Tech500/EoRa-S3-900TB-with-FreeRTOS/Doc/EoRa-S3-900TB Dev Board.png

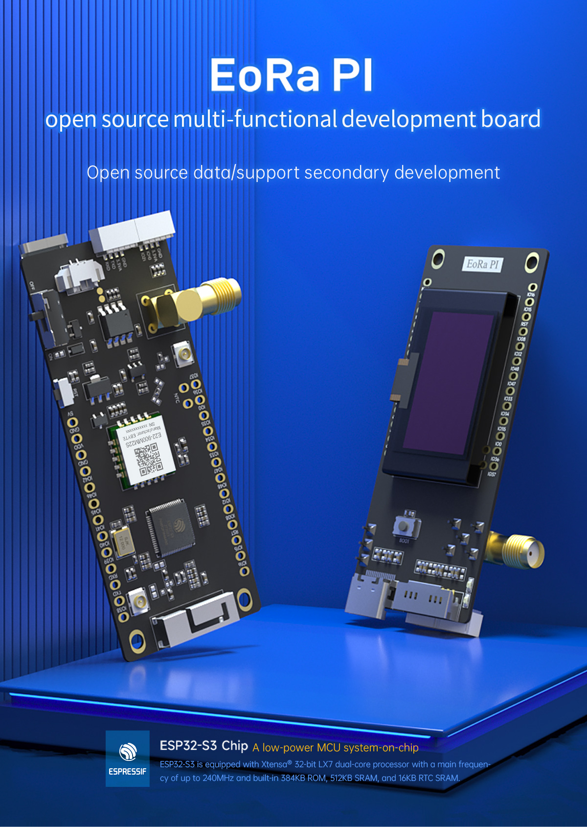
Doc/EoRa-S3-900TB Dev Board.png
