Tech500/EoRa-S3-900TB-with-FreeRTOS/Doc/Freertos_overview.md

# Why Use FreeRTOS?

FreeRTOS is a popular real-time operating system kernel for embedded systems. Here's why developers choose it:

## Real-Time Task Management

Without an RTOS, embedded code typically runs as one big loop, making it hard to guarantee when critical tasks execute. FreeRTOS lets you define tasks with priorities, ensuring time-critical work (e.g., reading a sensor, responding to an interrupt) always runs on time.

## Simplifies Complex Applications

Instead of manually juggling state machines and flags in a super-loop, you write each concern as its own independent task. This makes code easier to write, read, and maintain.

## Built-in Synchronization Primitives

FreeRTOS provides tools to safely coordinate between tasks and interrupts:

- **Queues** – pass data between tasks
- **Semaphores / Mutexes** – protect shared resources
- **Event groups** – signal multiple tasks at once
- **Timers** – run callbacks after delays or periodically

## Deterministic Behavior

The scheduler guarantees the highest-priority ready task always runs. This determinism is essential in safety- or timing-sensitive systems (motor control, medical devices, communications).

## Lightweight & Portable

FreeRTOS has a tiny footprint (can run in ~5KB RAM) and supports hundreds of microcontrollers — from tiny ARM Cortex-M0 chips to larger processors. It's hardware-agnostic by design.

## Free, Open Source & Well-Supported

- MIT licensed — free for commercial use
- Maintained by Amazon (AWS FreeRTOS ecosystem)
- Enormous community, documentation, and examples
- Used in millions of production devices

## Easier Debugging & Testing

Tasks can be developed and tested somewhat independently. FreeRTOS also provides stack overflow detection, runtime statistics, and trace hooks to help diagnose problems.

---

## When Not to Use FreeRTOS

It's worth noting that FreeRTOS isn't always the right choice:

- For very simple, single-purpose devices, a super-loop may be sufficient
- For Linux-capable hardware, a full OS (like embedded Linux) may be more appropriate
- It adds complexity — if you don't need concurrency, don't add it

> **The bottom line:** FreeRTOS shines when your embedded application has multiple concurrent concerns with different timing requirements, and you need a reliable, lightweight, and portable way to manage them.

---

# FreeRTOS: Importance to WiFi and Logic Operations

This is where FreeRTOS really demonstrates its value. WiFi and logic operations are a perfect example of why a super-loop falls short.

## The Core Problem Without FreeRTOS

Imagine a super-loop handling WiFi and logic:

```c
while(1) {
    read_sensors();        // takes 5ms
    process_logic();       // takes 10ms
    send_wifi_packet();    // takes 200ms  ← everything stalls here!
    check_alarms();        // dangerously delayed
}
```

Everything blocks everything else. WiFi operations are notoriously slow and unpredictable — your logic grinds to a halt waiting for network responses.

## How FreeRTOS Solves This

FreeRTOS lets you separate WiFi and logic into independent tasks:

```c
// High priority — time-critical logic
void logic_task(void *pvParams) {
    while(1) {
        read_sensors();
        run_control_logic();
        vTaskDelay(pdMS_TO_TICKS(10));  // runs every 10ms, reliably
    }
}

// Lower priority — WiFi can take as long as it needs
void wifi_task(void *pvParams) {
    while(1) {
        collect_data_from_queue();   // receives data safely from logic_task
        send_to_server();            // blocks here — logic_task unaffected!
        vTaskDelay(pdMS_TO_TICKS(1000));
    }
}
```

## Key Benefits for WiFi + Logic

### 🔁 Non-Blocking Concurrency

WiFi stack operations (connecting, sending, receiving, retrying) can block for hundreds of milliseconds. With FreeRTOS, the WiFi task blocks itself — the scheduler simply runs other tasks in the meantime. Your logic loop never misses a beat.

### 📬 Safe Data Passing via Queues

Your logic task produces data; your WiFi task consumes it. A queue bridges them safely:

```c
// In logic_task:
xQueueSend(dataQueue, &sensorReading, 0);

// In wifi_task:
xQueueReceive(dataQueue, &sensorReading, portMAX_DELAY); // → sends it over WiFi when ready
```

No race conditions, no shared variable corruption.

### ⚡ Priority-Based Responsiveness

| Task | Priority | Why |
|---|---|---|
| Safety/alarm logic  | HIGH | Must always respond instantly |
| Sensor processing | MEDIUM | Regular, timely updates needed |
| WiFi transmission | LOW | Slow, tolerant of delays |

If WiFi is busy and an alarm triggers, FreeRTOS preempts the WiFi task immediately.

### 🔄 WiFi Event Handling

WiFi generates asynchronous events (connected, disconnected, data received). FreeRTOS event groups or semaphores let your tasks react to these cleanly:

```c
// WiFi ISR/callback signals the task
xEventGroupSetBitsFromISR(wifiEvents, WIFI_CONNECTED_BIT, &taskWoken);

// WiFi task waits efficiently — uses zero CPU while waiting
xEventGroupWaitBits(wifiEvents, WIFI_CONNECTED_BIT, pdTRUE, pdFALSE, portMAX_DELAY);
```

### 🛡️ Resilience & Recovery

WiFi drops happen. With FreeRTOS, your reconnection logic lives in its own task — if it hangs or retries, **it doesn't take down your entire application.** Logic keeps running.

---

## Real-World Example: IoT Sensor Node

```
┌─────────────────────────────────────────────────────┐
│                  FreeRTOS Scheduler                 │
├─────────────────┬─────────────────┬─────────────────┤
│   Sensor Task   │  Control Logic  │    WiFi Task    │
│    (HIGH)       │    (MEDIUM)     │     (LOW)       │
│                 │                 │                 │
│   10ms tick     │   50ms tick     │ Whenever ready  │
└────────┬────────┴────────┬────────┴────────▲────────┘
         │                 │                 │
         │                 └──── Queue ──────┘
         │                   (sensor data)
         ▼
    Read Sensors
```

This architecture is the backbone of virtually every ESP32, STM32, or NXP-based IoT device using WiFi today — and FreeRTOS makes it manageable.

---

## Bottom Line

WiFi is slow, unpredictable, and event-driven. Logic is fast, regular, and time-sensitive. These two are fundamentally at odds in a super-loop — FreeRTOS is precisely the tool that lets them coexist gracefully, each getting the CPU time and priority it deserves.
