Tech500/EoRa-S3-900TB-with-FreeRTOS/Doc/NPPK II Observations.pdf

Initial EoRa-S3-900TB, Receiver power on.

One complete autoDutyCycle (Active listening for preamble; then LoRa inactive).

Active part of autoDutyCycle(); listening.

WOR Preamble received, Cmd = 1, timestamp. Flat line, radio.sleep();

ACK Received

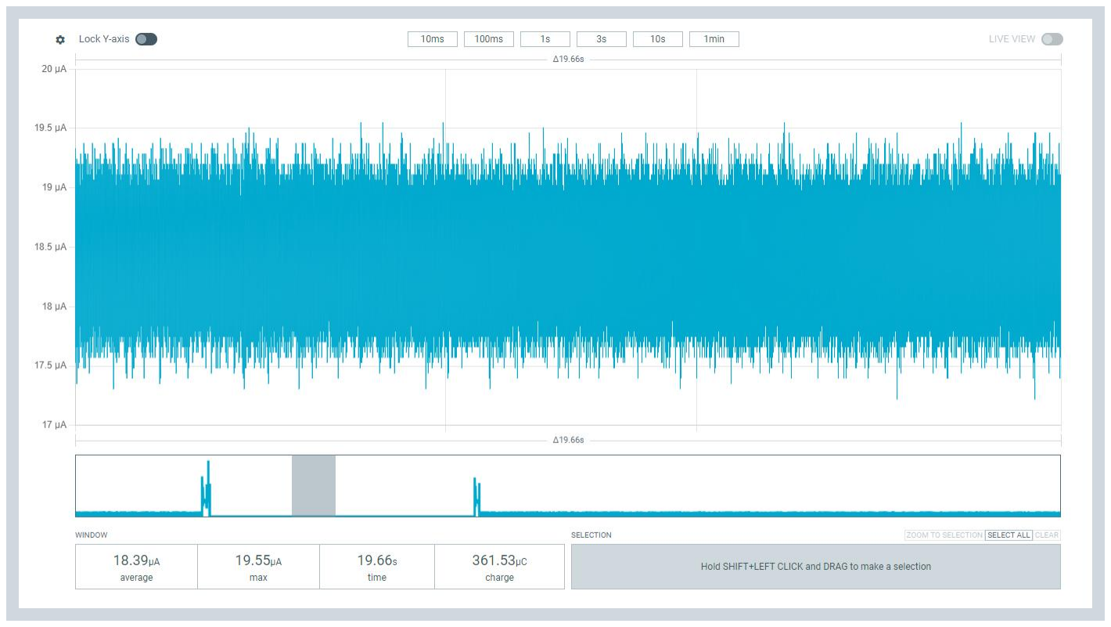
[picture p2: figure]

Called radio.sleep(), no transmit, no receive (powered down).

Timer EXT0 wake-up, radio.reset(), radio.init(), enterDeepSleepEXT0.

Receiver in EnterDeepSleepEXT0 listening for next preamble for next WOR preamble to Wake-up ESP32-S3.

Single listening event during autoDutyCycle();
