Tech500/EoRa-S3-900TB-with-FreeRTOS/Doc/NPPK_II_Battery_Life_Analysis.pdf

NPPK II — Battery Life Analysis 1

# NPPK II

### Battery Life Analysis –Claude (Anthropic's AI)

EoRa-S3-900TB | ESP32-S3 | WOR / EnterDeepSleepEXT0
February 2026 — Preliminary Estimate

## 1. System Overview

NPPK II is a web-triggered LoRa relay node. Visitors to the project website can click a relay link that causes a Transmitter to send a WOR (Wake-On-Radio) preamble, waking the receiver node from deep sleep to execute a command. Between web-triggered events, the receiver operates in EnterDeepSleepEXT0 mode — periodically waking to listen for a preamble, then immediately returning to deep sleep if none is detected.

Hardware platform: EoRa-S3-900TB (ESP32-S3 + SX1262 LoRa transceiver)
Battery: MakerFocus 3,000 mAh LiPo (3.7 V nominal)

## 2. Measured Current Data

All figures are derived from power profiler captures documented in NPPK_II_Observations.pdf.

Operating State | Avg Current | Duration | Charge
Power-on / radio init | 9.96 mA | 9.667 s | 96.27 mC
Single listen event (autoDutyCycle) | 8.40 mA | 9.530 ms | 80.01 µC
EnterDeepSleepEXT0 (idle listen loop avg) | 174.13 µA | continuous | —
radio.sleep() — fully powered down | 18.39 µA | — | —
WOR preamble received + full packet RX | 39.19 mA | 3.552 s | 139.24 mC
Timer EXT0 wake: reset + init + re-sleep | 36.81 mA | 1.927 s | 70.94 mC

Note: Transmit current not yet measured. TX events are not expected in normal receiver-only operation of NPPK II but will be documented when data is available.

## 3. Usage Assumptions

Web traffic data from 2017 indicates approximately 12 homepage visits per day. The fraction of visitors who click the relay link is unknown; estimates below use a conservative range.

Parameter | Value / Assumption
Homepage hits / day (2017 baseline) | ~12
Estimated relay trigger rate | 3–5 / day (25–40% click-through)
Battery capacity | 3,000 mAh @ 3.7 V
Dominant operating mode | EnterDeepSleepEXT0 listen loop
LiPo self-discharge rate | ~2–3% / month

## 4. Battery Life Estimate

### 4.1 Standby (EnterDeepSleepEXT0 only, no triggers)

The device spends the vast majority of its time in EnterDeepSleepEXT0, periodically waking for a brief listen event. The measured average current across a full 60-second window is 174.13 µA, which already accounts for all listen pulses and return-to-sleep transitions.

3,000 mAh ÷ 0.174 mA ≈ 17,241 hours ≈ 718 days ≈ ~2.0 years

This represents the upper bound — actual operational life will be slightly reduced by triggered receive events.

### 4.2 With Web-Triggered Receive Events

Each full WOR wake cycle (preamble receive + command processing + radio re-init) consumes approximately 210 mC total (139.24 mC RX + 70.94 mC re-init). At 5 triggers per day:

Daily trigger charge: 5 × 210 mC = 1,050 mC = 0.292 mAh / day
Daily standby charge: 0.174 mA × 24 h = 4.176 mAh / day
Total daily consumption: ~4.47 mAh / day

3,000 mAh ÷ 4.47 mAh/day ≈ 671 days ≈ ~1.84 years

Triggered events add less than 7% overhead to standby consumption at 5 triggers/day — operationally negligible.

### 4.3 Self-Discharge Consideration

LiPo batteries self-discharge at approximately 2–3% per month regardless of load. For a 3,000 mAh cell this equates to 60–90 mAh/month. Over the projected ~670-day service life, self-discharge accounts for roughly 1,300–1,950 mAh of total loss — approaching the same order of magnitude as operational consumption. Self-discharge is therefore a significant real-world factor and may be the dominant limit on service life if the battery has been in storage.

Scenario | Estimated Service Life
Pure standby, no triggers | ~718 days (~2.0 years)
5 relay triggers / day | ~671 days (~1.84 years)
10 relay triggers / day | ~626 days (~1.71 years)
Self-discharge only (no operation) | ~3–4 years to full depletion

## 5. Notes & Limitations

- TX current profile not yet captured. NPPK II receiver is not expected to transmit in normal operation; if any ACK or response TX is implemented, that data should be added.
- Web traffic figure is from 2017. Current traffic may differ significantly. Estimates should be revisited once live monitoring is in place.
- JST connector not yet accessed for battery condition assessment. If battery has been in extended storage, effective capacity may be reduced below 3,000 mAh nominal.
- EnterDeepSleepEXT0 average (174 µA) includes periodic listen pulse overhead and is the best single figure for long-term idle consumption modeling.
- All calculations assume constant 3.7 V supply. Actual LiPo discharge curve means effective capacity at low voltages may vary with regulator cutoff threshold.

## 6. Conclusion

NPPK II demonstrates excellent power efficiency in its EnterDeepSleepEXT0 listening mode. Projected operational battery life of approximately 1.8–2.0 years on a 3,000 mAh LiPo is well-suited for an infrequently-triggered remote relay application. Self-discharge is the primary real-world constraint and should be evaluated once the JST connector and battery condition can be assessed.
