Tech500/EoRa-S3-900TB-with-FreeRTOS/Doc/EoRa-S3-900TB Pin Definition.png

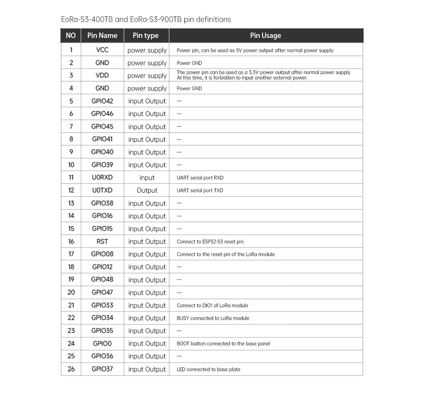
Doc/EoRa-S3-900TB Pin Definition.png
