Tech500/EoRa-S3-900TB-with-FreeRTOS/Doc/Pin Definition.png

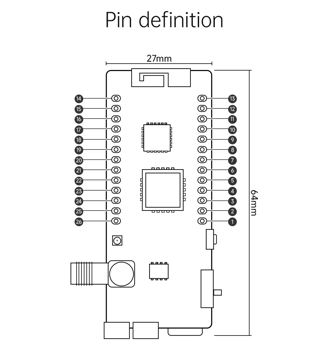
Doc/Pin Definition.png
