Tech500/EoRa-S3-900TB-with-FreeRTOS/Images/One complete cycle on-off.png

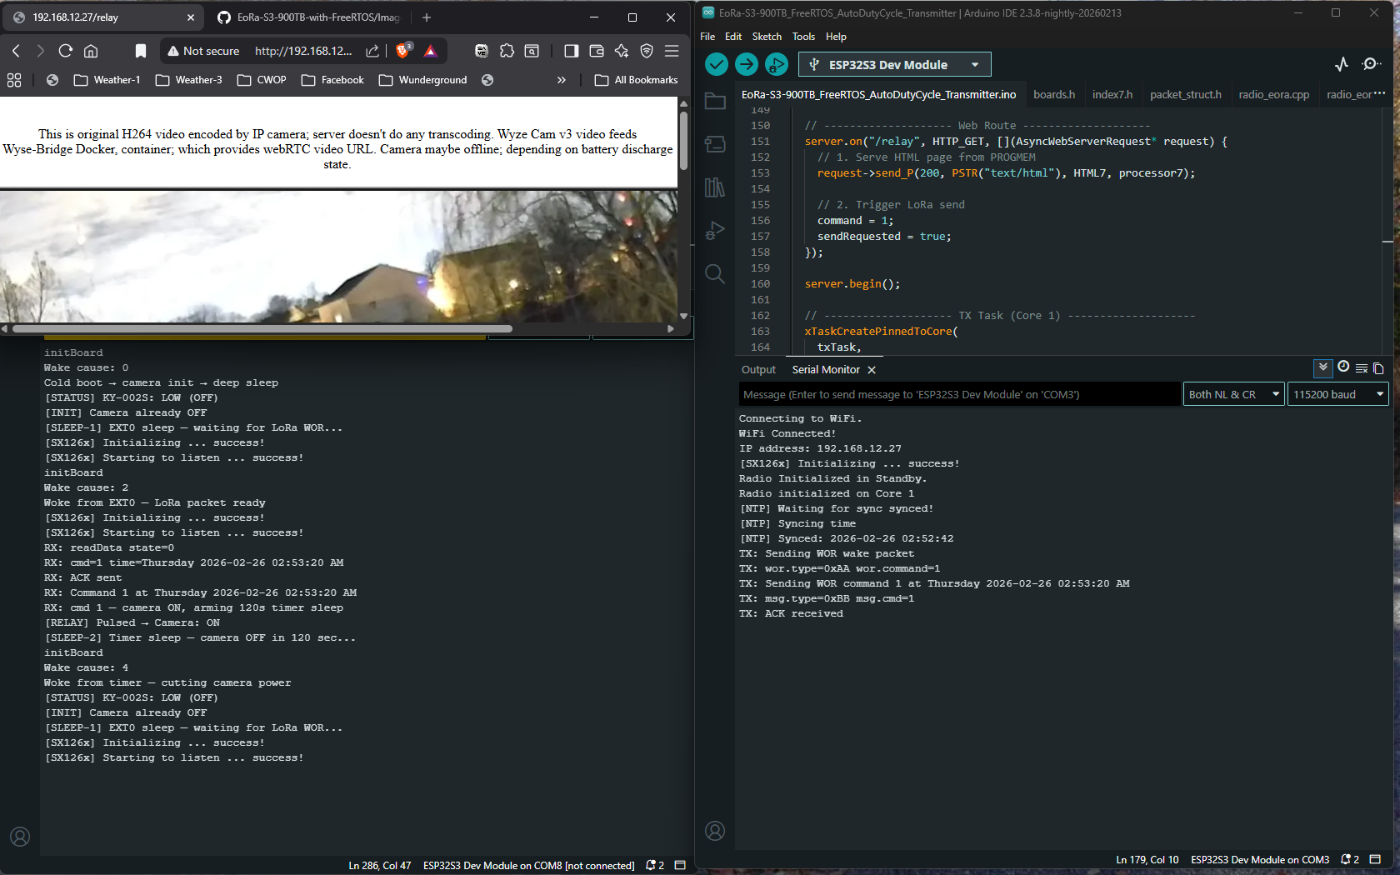
Images/One complete cycle on-off.png
