Tech500/EoRa-S3-900TB-with-FreeRTOS/Images/radio.sleep.png

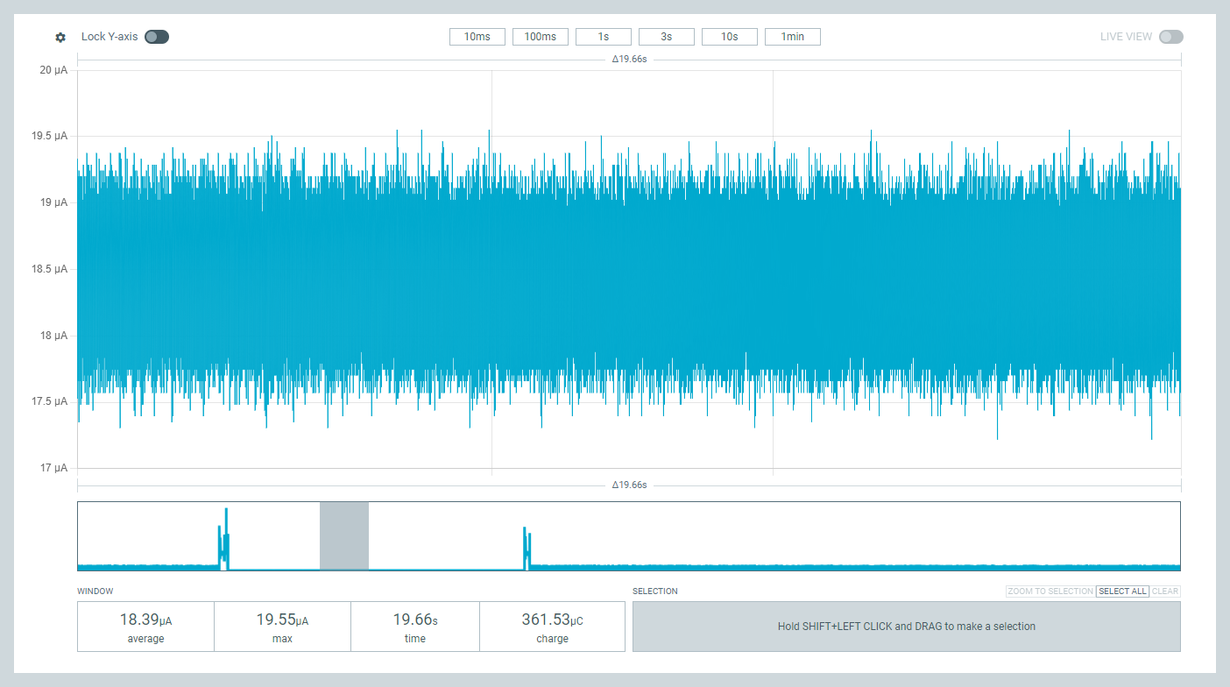
Images/radio.sleep.png
