Tech500/EoRa-S3-900TB-with-FreeRTOS/Images/timer wake-up.png

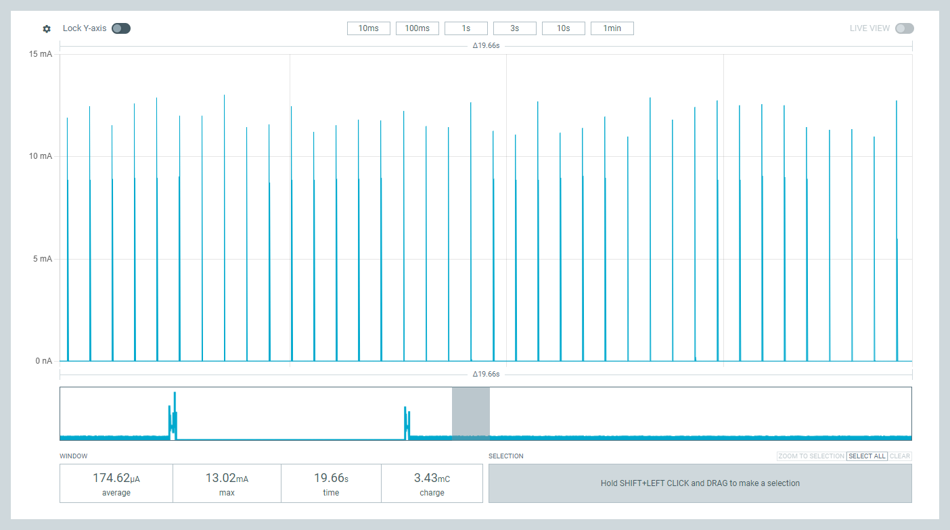
Images/timer wake-up.png
