Tech500/EoRa-S3-900TB-with-FreeRTOS/Schematic/EoRa-S3-900TB-with-FreeRTOS --Receiver.png

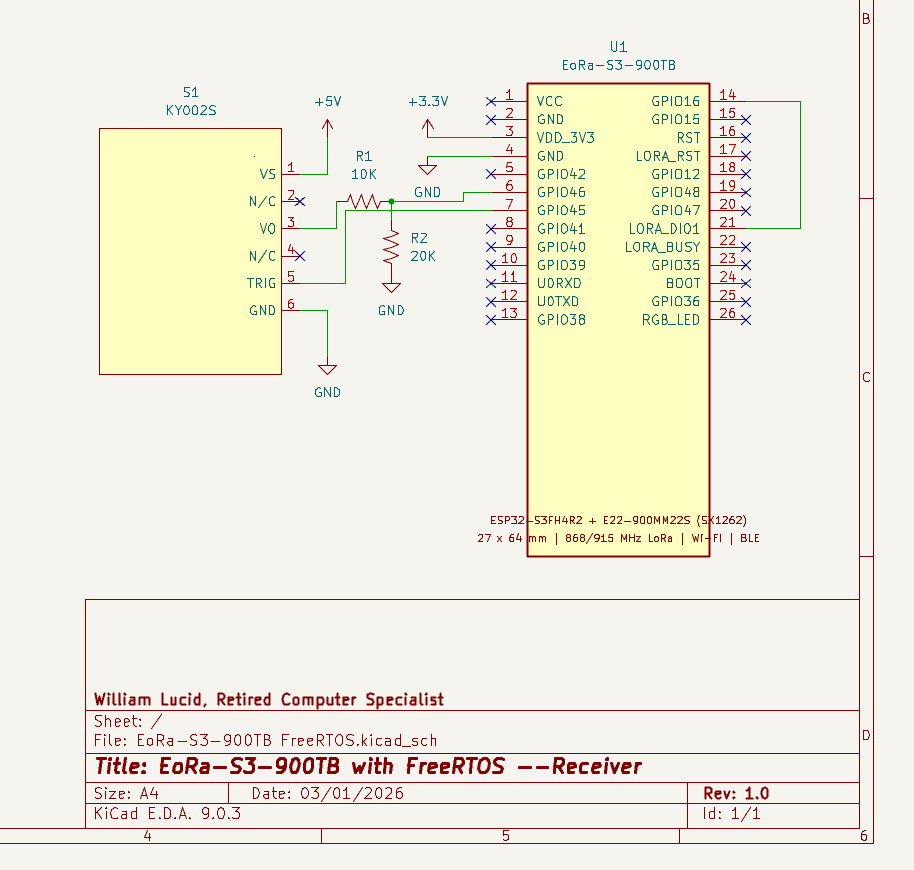
Schematic/EoRa-S3-900TB-with-FreeRTOS --Receiver.png
